ThoreLencer/Spielkonsole/README.md

Dieses Repository enthält den Code für eine arduinobasierte Handheld-Spielekonsole. Die volle Dokumentation finden Sie ebenfalls in diesem Repo als PDF-Datei.
